alextrical/ESP32-Sentinel-Kinetic-Wireless-Dongle/README.md

# ESP32-Vent-Axia-Sentinel-Kinetic-Wired-Remote-Dongle
ESP32 based Re-implementation of the Vent-Axia Sentinel Kinetic Wired Remote Controller
Arduino sketch can be simulated here
https://wokwi.com/projects/427157112827024385
