alextrical/ESP32-Sentinel-Kinetic-Wireless-Dongle/ESP32-Sentinel-Kinetic-Wireless-Dongle.pdf

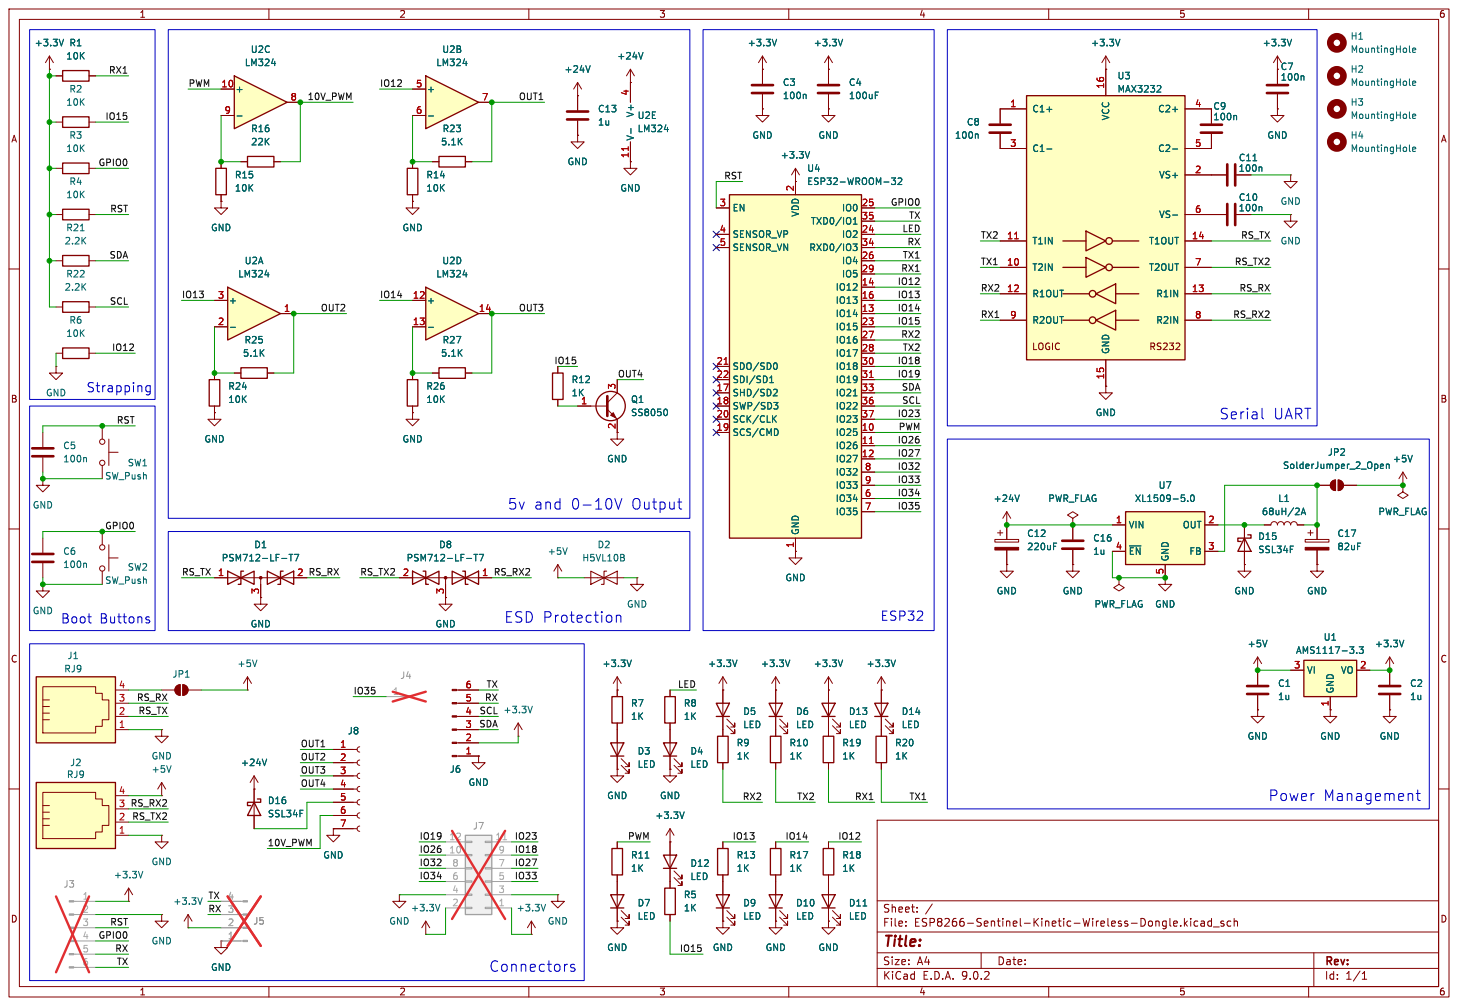
[picture p1: page 1]
