alextrical/ESP32-Sentinel-Kinetic-Wireless-Dongle/ESP32-Sentinel-Kinetic-Wireless-Dongle.kicad_pcb

## KiCad design ESP32-Sentinel-Kinetic-Wireless-Dongle.kicad_pcb (2025-07-14)

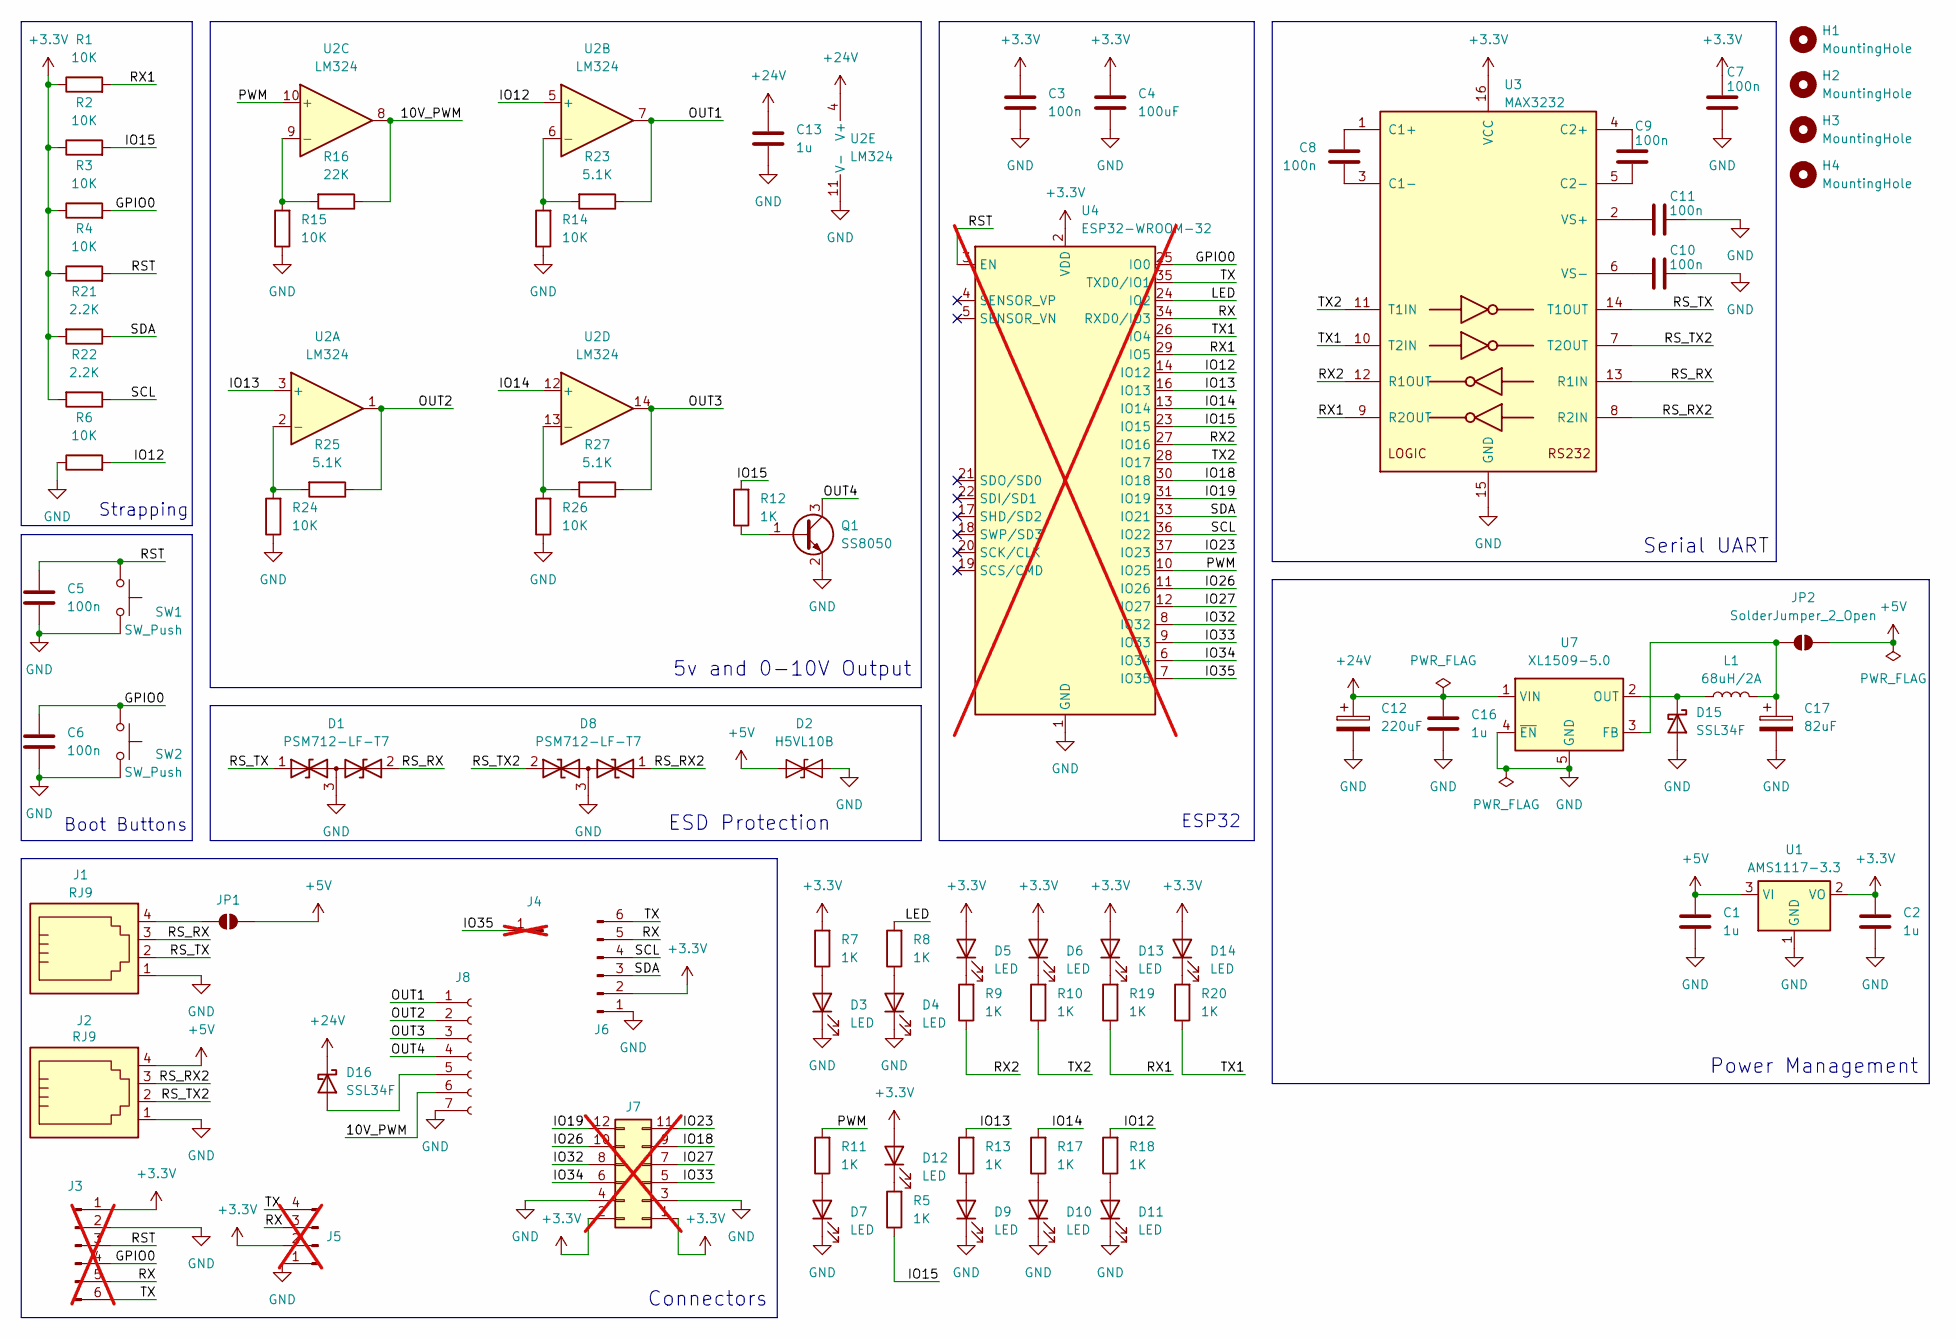
[picture p2: schematic ESP32-Sentinel-Kinetic-Wireless-Dongle.kicad_sch]

Parts:
C1, C2: 1u; C_0402_1005Metric; LCSC C52923
C3, C5, C6, C7, C8, C9, C10, C11: 100n; C_0402_1005Metric; LCSC C307331
C4: 100uF; C_1206_3216Metric; LCSC C15008
C12: 220uF; CP_Radial_D10.0mm_P5.00mm
C13, C16: 1u; C_1206_3216Metric; LCSC C1848
C17: 82uF; CP_Radial_D10.0mm_P2.50mm_P5.00mm
D1, D8: PSM712-LF-T7; SOT-23; LCSC C32677
D2: H5VL10B; D_SOD-882; LCSC C7420372
D3, D4, D5, D6, D7, D9, D10, D11, D12, D13, D14: LED; LED_0603_1608Metric; LCSC C2286
D15, D16: SSL34F; D_SMA; LCSC C28646282
H1, H2, H3, H4: MountingHole; MountingHole_3.2mm_M3
J1, J2: RJ9; RJ9-TH-623K-4P4CGRAYBOUNDLESS
J3: Conn_01x06_Pin; PinHeader_1x06_P2.00mm_Vertical_locking; not fitted
J4: Conn_01x01_Pin; PinHeader_1x01_P2.54mm_Vertical; not fitted
J5: Conn_01x04_Pin; PinHeader_1x04_P2.54mm_Vertical; not fitted
J6: Conn_01x06_Pin; JST_XH_B6B-XH-A_1x06_P2.50mm_Vertical
J7: Conn_02x06_Odd_Even; PinHeader_2x06_P2.54mm_Vertical; not fitted
J8: Conn_01x07_Socket; JST_XH_B7B-XH-A_1x07_P2.50mm_Vertical
JP1, JP2: SolderJumper_2_Open; SolderJumper-2_P1.3mm_Open_RoundedPad1.0x1.5mm
L1: 68uH/2A; L_APV_APH0850; LCSC C41415633
Q1: SS8050; SOT-23; LCSC C431710
R1, R2, R3, R4, R6, R14, R15, R24, R26: 10K; R_0402_1005Metric; LCSC C25744
R5, R7, R8, R9, R10, R11, R12, R13, R17, R18, R19, R20: 1K; R_0402_1005Metric; LCSC C11702
R16: 22K; R_0402_1005Metric; LCSC C25768
R21, R22: 2.2K; R_0402_1005Metric; LCSC C25879
R23, R25, R27: 5.1K; R_0402_1005Metric; LCSC C25905
SW1, SW2: SW_Push; SW_Push_1P1T_XKB_TS-1187A; LCSC C318884
U1: AMS1117-3.3; SOT-223-3_TabPin2; LCSC C6186
U2: LM324; SOIC-14_3.9x8.7mm_P1.27mm; LCSC C71035
U3: MAX3232; SOP-16_3.9x9.9mm_P1.27mm; LCSC C5201633
U4: ESP32-WROOM-32; not fitted
U7: XL1509-5.0; SOIC-8_3.9x4.9mm_P1.27mm; LCSC C61063

Connections:
+3.3V: C2.1, C3.1, C4.1, C7.1, D5.2 (A), D6.2 (A), D12.2 (A), D13.2 (A), D14.2 (A), J3.1, J5.2, J6.2, J7.1, J7.2, R1.1, R2.1, R3.1, R4.1, R7.2, R21.2, R22.2, U1.2 (VO), U3.16 (VCC), U4.2 (VDD)
+5V: C1.1, D2.1 (A1), J2.4, JP1.2 (B), JP2.2 (B), U1.3 (VI)
+24V: C12.1, C13.1, C16.1, D16.1 (K), U2.4 (V+), U7.1 (VIN)
/10V_PWM: J8.6, R16.1, U2.8
/GPIO0: C6.1, J3.4, R3.2, SW2.1, U4.25 (IO0)
/IO12: R6.2, R18.2, U2.5 (+), U4.14 (IO12)
/IO13: R13.2, U2.3 (+), U4.16 (IO13)
/IO14: R17.2, U2.12 (+), U4.13 (IO14)
/IO15: R2.2, R5.1, R12.2, U4.23 (IO15)
/IO18: J7.9, U4.30 (IO18)
/IO19: J7.12, U4.31 (IO19)
/IO23: J7.11, U4.37 (IO23)
/IO26: J7.10, U4.11 (IO26)
/IO27: J7.7, U4.12 (IO27)
/IO32: J7.8, U4.8 (IO32)
/IO33: J7.5, U4.9 (IO33)
/IO34: J7.6, U4.6 (IO34)
/IO35: J4.1, U4.7 (IO35)
/LED: R8.2, U4.24 (IO2)
/OUT1: J8.1, R23.1, U2.7
/OUT2: J8.2, R25.1, U2.1
/OUT3: J8.3, R27.1, U2.14
/OUT4: J8.4, Q1.3 (C)
/PWM: R11.2, U2.10 (+), U4.10 (IO25)
/RST: C5.1, J3.3, R4.2, SW1.1, U4.3 (EN)
/RS_RX: D1.2 (A2), J1.3, U3.13 (R1IN)
/RS_RX2: D8.1 (A1), J2.3, U3.8 (R2IN)
/RS_TX: D1.1 (A1), J1.2, U3.14 (T1OUT)
/RS_TX2: D8.2 (A2), J2.2, U3.7 (T2OUT)
/RX: J3.5, J5.3, J6.5, U4.34 (RXD0/IO3)
/RX1: R1.2, R19.1, U3.9 (R2OUT), U4.29 (IO5)
/RX2: R9.1, U3.12 (R1OUT), U4.27 (IO16)
/SCL: J6.4, R22.1, U4.36 (IO22)
/SDA: J6.3, R21.1, U4.33 (IO21)
/TX: J3.6, J5.4, J6.6, U4.35 (TXD0/IO1)
/TX1: R20.1, U3.10 (T2IN), U4.26 (IO4)
/TX2: R10.1, U3.11 (T1IN), U4.28 (IO17)
GND: C1.2, C2.2, C3.2, C4.2, C5.2, C6.2, C7.2, C10.2, C11.2, C12.2, C13.2, C16.2, C17.2, D1.3 (common), D2.2 (A2), D3.1 (K), D4.1 (K), D7.1 (K), D8.3 (common), D9.1 (K), D10.1 (K), D11.1 (K), D15.2 (A), J1.1, J2.1, J3.2, J5.1, J6.1, J7.3, J7.4, J8.7, Q1.2 (E), R6.1, R14.1, R15.1, R24.1, R26.1, SW1.2, SW2.2, U1.1 (GND), U2.11 (V-), U3.15 (GND), U4.1 (GND), U4.15 (GND), U4.38 (GND), U4.39 (GND), U7.4 (~EN), U7.5 (GND), U7.6 (GND), U7.7 (GND), U7.8 (GND)
unnamed: D3.2 (A), R7.1
unnamed: D4.2 (A), R8.1
unnamed: D5.1 (K), R9.2
unnamed: D6.1 (K), R10.2
unnamed: D7.2 (A), R11.1
unnamed: D9.2 (A), R13.1
unnamed: D10.2 (A), R17.1
unnamed: D11.2 (A), R18.1
unnamed: D12.1 (K), R5.2
unnamed: D13.1 (K), R19.2
unnamed: D14.1 (K), R20.2
unnamed: D15.1 (K), L1.1, U7.2 (OUT)
unnamed: D16.2 (A), J8.5
unnamed: J1.4, JP1.1 (A)
unnamed: C17.1, JP2.1 (A), L1.2, U7.3 (FB)
unnamed: Q1.1 (B), R12.1
unnamed: R24.2, R25.2, U2.2 (-)
unnamed: R14.2, R23.2, U2.6 (-)
unnamed: R15.2, R16.2, U2.9 (-)
unnamed: R26.2, R27.2, U2.13 (-)
unnamed: C8.1, U3.1 (C1+)
unnamed: C8.2, U3.3 (C1-)
unnamed: C9.1, U3.4 (C2+)
unnamed: C9.2, U3.5 (C2-)
unnamed: C11.1, U3.2 (VS+)
unnamed: C10.1, U3.6 (VS-)

Notes on the sheet:
ESP32
5v and 0-10V Output
Boot Buttons
Strapping
Power Management
Serial UART
Connectors
ESD Protection

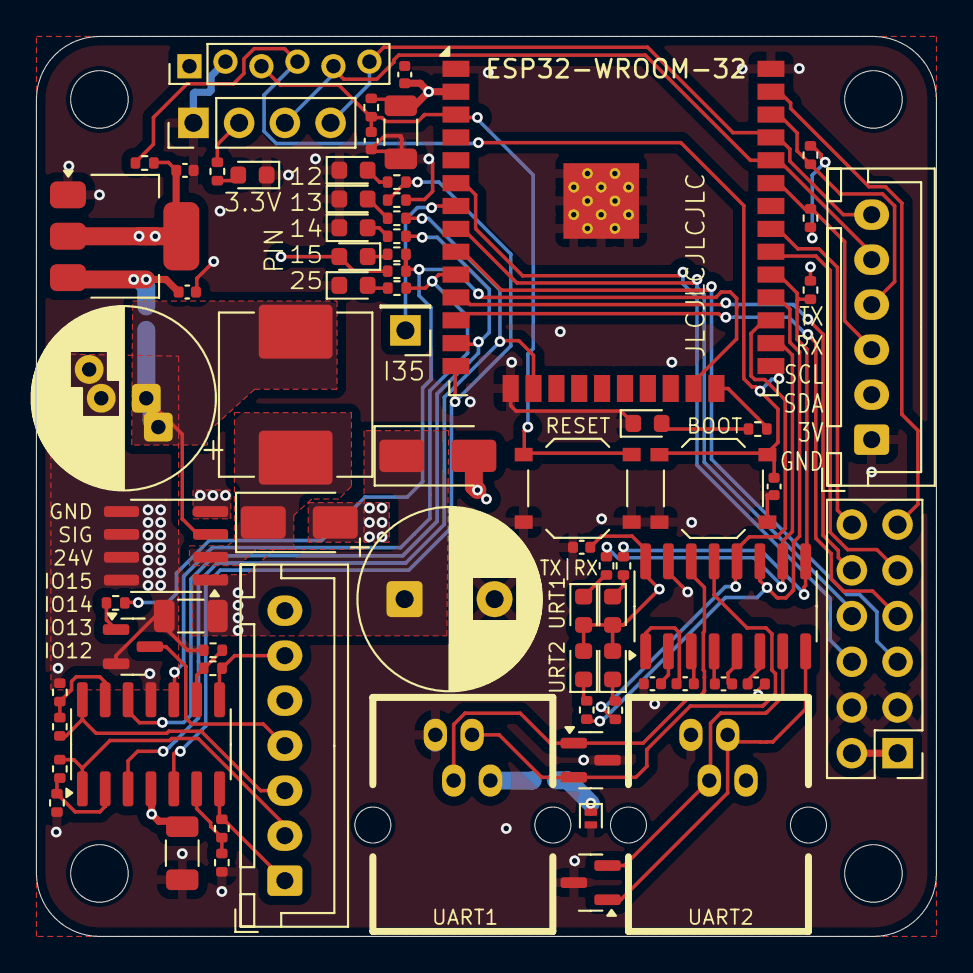
[picture p3: board ESP32-Sentinel-Kinetic-Wireless-Dongle.kicad_pcb from above]

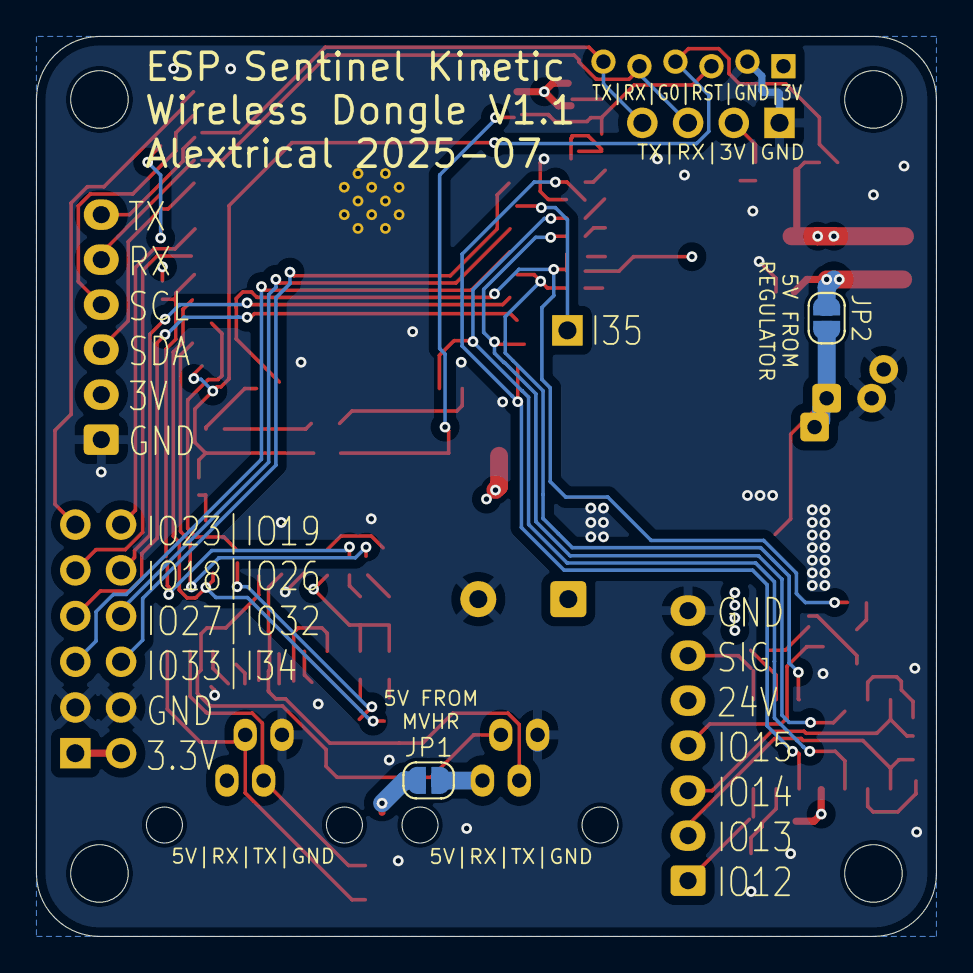
[picture p4: board ESP32-Sentinel-Kinetic-Wireless-Dongle.kicad_pcb from below]

Board: 4 copper layers, 50.0 x 50.0 mm, 81 parts (2 on the bottom side), 64 nets.
