alextrical/ESP32-Sentinel-Kinetic-Wireless-Dongle/Manufacturing Notes/Manufacturing Notes.txt

Add any manufacturing notes in here. It will be copied to the Artifact
