alextrical/ESP32-Sentinel-Kinetic-Wireless-Dongle/(commit log)

2025-06-12 Added PDF and OSHW logo
    [ESP8266-Sentinel-Kinetic-Wireless-Dongle.kicad_pcb]
2025-06-18 Completed PCB Layout Added PWM Rail to rail Added Silkscreen markings
    [ESP8266-Sentinel-Kinetic-Wireless-Dongle.kicad_pcb, ESP8266-Sentinel-Kinetic-Wireless-Dongle.kicad_sch]
2025-06-18 Added LCSC Part Numbers
    [ESP8266-Sentinel-Kinetic-Wireless-Dongle.kicad_pcb, ESP8266-Sentinel-Kinetic-Wireless-Dongle.kicad_sch]
2025-06-19 corrected rx and tx positions for lilygo downloader
    [ESP8266-Sentinel-Kinetic-Wireless-Dongle.kicad_pcb, ESP8266-Sentinel-Kinetic-Wireless-Dongle.kicad_sch]
2025-06-21 Include push buttons in BOM
    [ESP8266-Sentinel-Kinetic-Wireless-Dongle.kicad_pcb, ESP8266-Sentinel-Kinetic-Wireless-Dongle.kicad_sch]
2025-07-05 Added Silkscreen markings to Diagnostic LED's Inverted Serial LED's, so LED is only on when signal is sent or recieved.
    [ESP8266-Sentinel-Kinetic-Wireless-Dongle.kicad_pcb, ESP8266-Sentinel-Kinetic-Wireless-Dongle.kicad_sch]
2025-07-10 Applied fixes to issues from V1 Inverted LED's on UART to indicate only when data is sent Added Second UART to allow passthrough Removed support for ESP8266
    Still need to add:
    pin breakout for user mods
    Buck regulator from 24V. We need more current on the 5V rail than available, if we expect anything else to be connected up (and not cause a brown out)
    [ESP8266-Sentinel-Kinetic-Wireless-Dongle.kicad_sch]
2025-07-12 Layout completed Revesed RJ9 pinout to match Display Module Added reverse polarity protection diode to 24V rail Using OpAMP for 3.3 to 5V conversion Using OpAmp for 3.3 to 10V conversion JST XH for M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
    [ESP8266-Sentinel-Kinetic-Wireless-Dongle.kicad_pcb, ESP8266-Sentinel-Kinetic-Wireless-Dongle.kicad_sch]
2025-07-12 Update PDF schematic
2025-07-14 Renamed Project for ESP32
    [ESP32-Sentinel-Kinetic-Wireless-Dongle.kicad_pcb, ESP32-Sentinel-Kinetic-Wireless-Dongle.kicad_sch]
2025-07-14 Updated LCSC numbers
    [ESP32-Sentinel-Kinetic-Wireless-Dongle.kicad_pcb, ESP32-Sentinel-Kinetic-Wireless-Dongle.kicad_sch]
2025-07-16 Replaced project name references from ESP8266 to ESP32
    [ESP32-Sentinel-Kinetic-Wireless-Dongle.kicad_sch]
